RCPilot1604/Player-Piano/README.md

**Work in progress**
Detailed writeup here: https://urbanmakerkraft.com/2024/08/10/player-piano-project-v1/
