RCPilot1604/Player-Piano/Player Piano/src/Schematic.docx

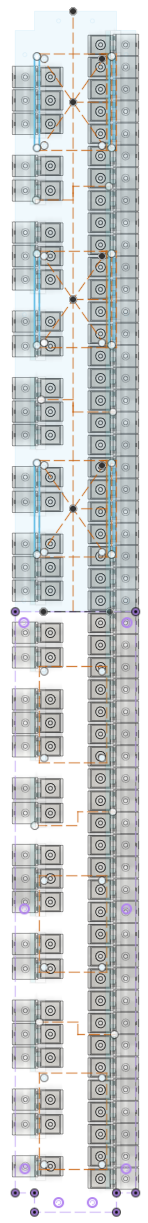
[picture p1: figure]
