RCPilot1604/Player-Piano/CAD/Player Piano Mechanism v41.step

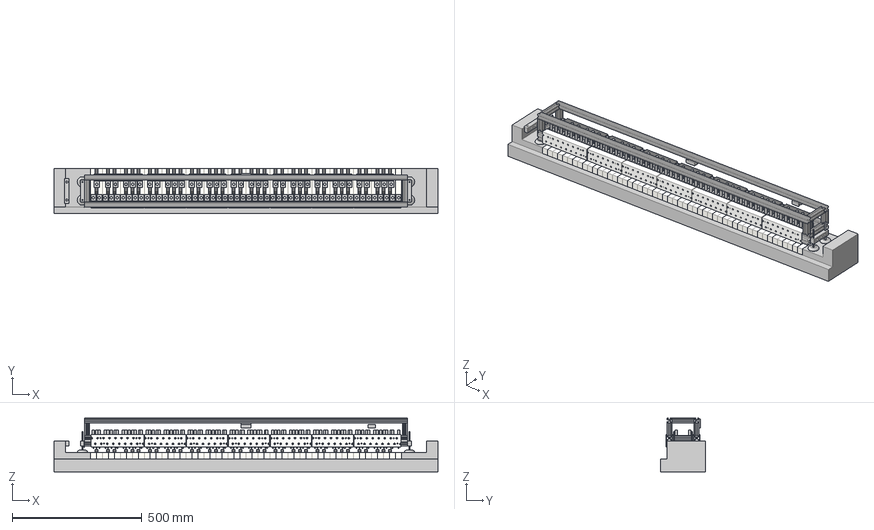
[picture p2: CAD file, 2025-01-10]
CAD/Player Piano Mechanism v41.step
1480.0 x 175.0 x 207.8 mm
Left Depth Rail
Positioning_Pole
Right Depth Rail
Legs
Front Left Pillar
2040 Profile
Back Left Pillar
Front Right Pillar
Back Right Pillar
Top Left Depth Rail
Top Right Depth Rail
Top Front Length Rail
Top Back Length Rail
2040 Profile(Mirror)
White
Black
Coil x 88
Frame_1 x 88
Plunger x 88
New White Solenoid Mount
New Black Solenoid Mount
PCB
