RCPilot1604/Player-Piano/(list of files, cad)

Other CAD files:
CAD/Player Piano Mechanism.f3z
