RCPilot1604/Player-Piano/EAGLE/Board.brd

## EAGLE design EAGLE/Board.brd (2024-07-26)

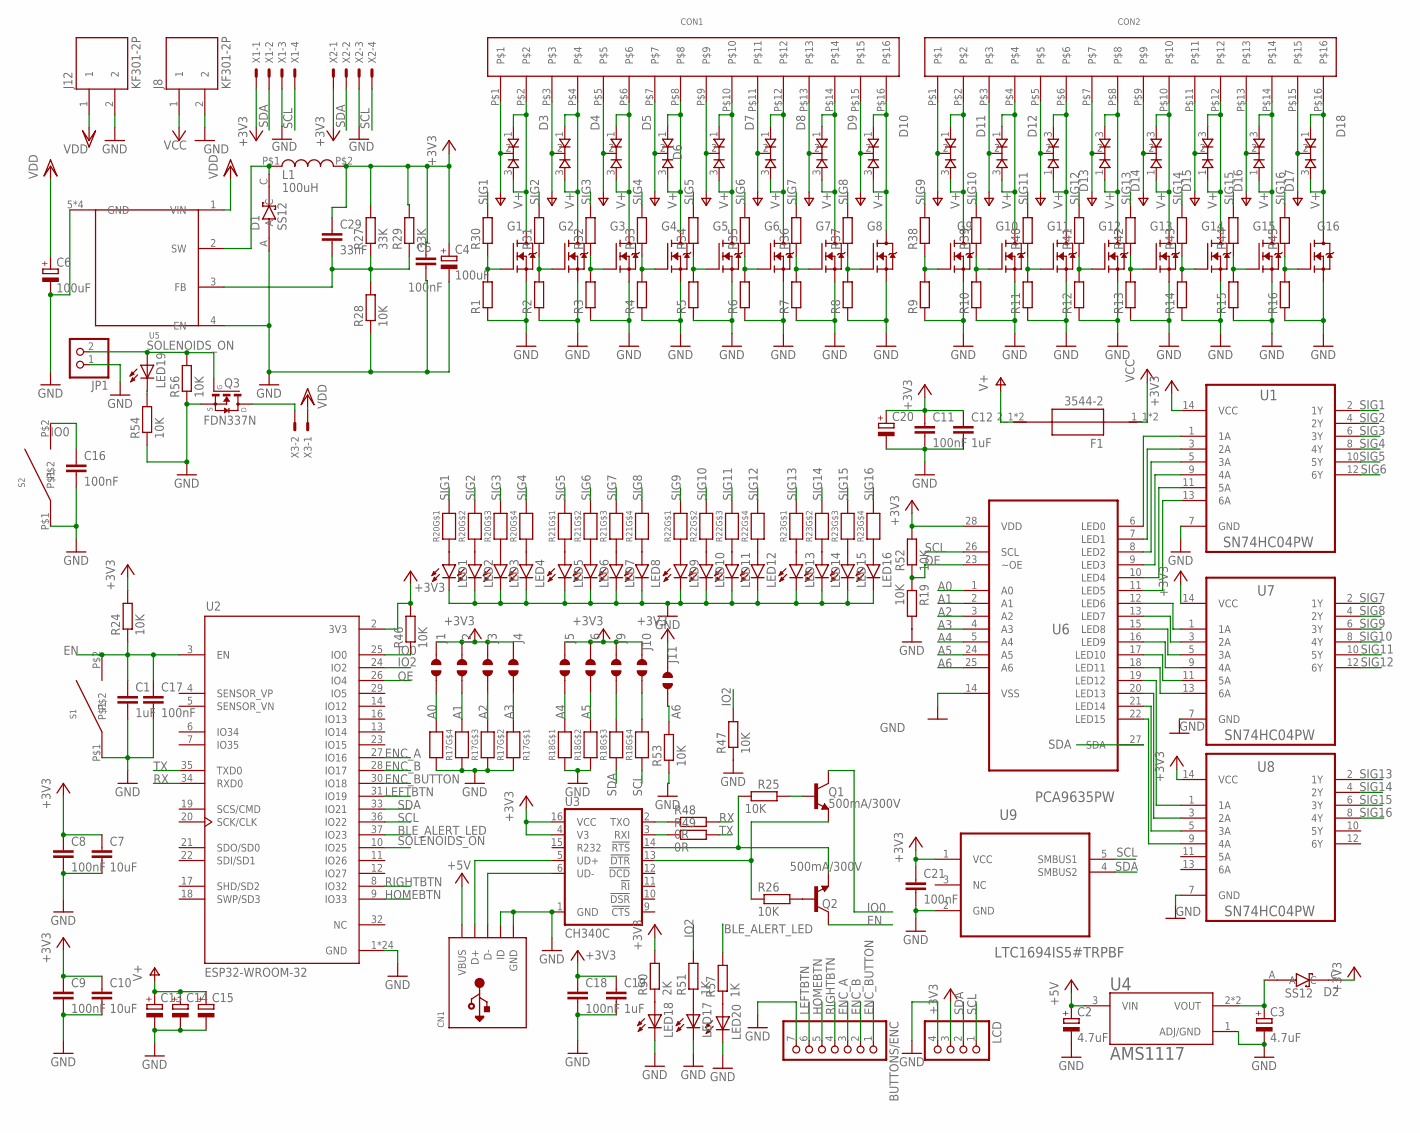
[picture p3: schematic Board.sch]

Parts:
BUTTONS/ENC: PINHD-1X7; 1X07
C1, C12, C19: 1uF; C0603
C2, C3: 4.7uF; C/6032-28R
C4, C6: 100uF; C/6032-28R
C5, C8, C9, C11, C16, C17, C18, C21: 100nF; C0603
C7, C10: 10uF; C0603
C13, C14, C15: CPOL-EUE5-10.5; E5-10,5
C20: CPOL-EUB; PANASONIC_B
C29: 33nF; C0603
CN1: USBMINIB; USB-MINIB
CON1, CON2: 2.54-16P
D1, D2: SS12; DIOM4427X270N
D3, D4, D5, D6, D7, D8, D9, D10, D11, D12, D13, D14, D15, D16, D17, D18: BYQ28E; TO220V
F1: 3544-2; FUSE_3544-2
G1, G2, G3, G4, G5, G6, G7, G8, G9, G10, G11, G12, G13, G14, G15, G16: IRL540N; TO220V
J1, J2, J3, J4, J5, J6, J9, J10, J11: JUMPER_SOLDER_1X2
J8, J12: KF301-2P
JP1: PINHD-1X2; 1X02
L1: 100uH; CD43
LCD: PINHD-1X4; 1X04
LED1, LED2, LED3, LED4, LED5, LED6, LED7, LED8, LED9, LED10, LED11, LED12, LED13, LED14, LED15, LED16: LEDSMT1206; 1206
LED17, LED18, LED19, LED20: LED-0603; LED-603
Q1, Q2: 500mA/300V; SOT23-3
Q3: FDN337N; SSOT-3
R1, R2, R3, R4, R5, R6, R7, R8, R9, R10, R11, R12, R13, R14, R15, R16, R30, R31, R32, R33, R34, R35, R36, R37, R38, R39, R40, R41, R42, R43, R44, R45: R-EU_R0603; R0603
R17, R18, R20, R21, R22, R23: MICROBUILDER_RESISTOR_4PACK; MICROBUILDER_RESPACK_4X0603
R19: 10K; R1206
R24, R25, R26, R28, R46, R47, R52, R53, R54, R56: 10K; R0603
R27, R29: 33K; R0603
R48, R49: 0R; R0603
R50: 2K; R0603
R51, R57: 1K; R0603
S1, S2: 3X6X2.5
U1, U7, U8: SN74HC04PW; SOP65P640X120-14N
U2: ESP32-WROOM-32; MODULE_ESP32-WROOM-32
U3: CH340C; SO016
U4: AMS1117; SOT229P700X180-4N
U5: XL7005A; SO8
U6: PCA9635PW; SOP65P640X110-28N
U9: LTC1694IS5#TRPBF; SOT95P280X100-5N
X1, X2: JST-XH-04-PIN-LONG-PAD; JST-XH-04-PACKAGE-LONG-PAD
X3: JST-XH-02-PIN-LONG-PAD; JST-XH-02-PACKAGE-LONG-PAD

Connections:
+3V3: C4.+, C5.1, C7.1, C8.1, C9.1, C10.1, C11.1, C12.1, C18.1, C19.1, C20.+, C21.1, C29.1, D2.C, J1.1, J2.1, J3.1, J4.1, J5.1, J6.1, J9.1, J10.1, J11.1, L1.P$2, LCD.3, R24.2, R27.2, R29.2, R46.2, R50.2, R52.2, U1.14 (VCC), U2.2 (3V3), U3.4 (V3), U3.16 (VCC), U6.28 (VDD), U7.14 (VCC), U8.14 (VCC), U9.1 (VCC), X1.1, X2.1
+5V: C2.+, CN1.VBUS, U4.3 (VIN)
A0: J1.2, R17.4 (1), U6.1 (A0)
A1: J2.2, R17.3 (1), U6.2 (A1)
A2: J3.2, R17.2 (1), U6.3 (A2)
A3: J4.2, R17.1, U6.4 (A3)
A4: J5.2, R18.8 (2), U6.5 (A4)
A5: J6.2, R18.7 (2), U6.24 (A5)
A6: J11.2, R53.2, U6.25 (A6)
BLE_ALERT_LED: R57.2, U2.37 (IO23)
EN: C1.1, C17.1, Q2.3 (C), R24.1, S1.P$2, U2.3 (EN)
ENC_A: BUTTONS/ENC.3, U2.27 (IO16)
ENC_B: BUTTONS/ENC.2, U2.28 (IO17)
ENC_BUTTON: BUTTONS/ENC.1, U2.30 (IO18)
GND: BUTTONS/ENC.7, C1.2, C2.-, C3.-, C4.-, C5.2, C6.-, C7.2, C8.2, C9.2, C10.2, C11.2, C12.2, C13.-, C14.-, C15.-, C16.2, C17.2, C18.2, C19.2, C20.-, C21.2, CN1.GND, CN1.ID, D1.A, G1.3 (S), G2.3 (S), G3.3 (S), G4.3 (S), G5.3 (S), G6.3 (S), G7.3 (S), G8.3 (S), G9.3 (S), G10.3 (S), G11.3 (S), G12.3 (S), G13.3 (S), G14.3 (S), G15.3 (S), G16.3 (S), J8.2, J12.2, JP1.1, LCD.4, LED1.C, LED2.C, LED3.C, LED4.C, LED5.C, LED6.C, LED7.C, LED8.C, LED9.C, LED10.C, LED11.C, LED12.C, LED13.C, LED14.C, LED15.C, LED16.C, LED17.C, LED18.C, LED20.C, Q3.2 (S), R1.1, R2.1, R3.1, R4.1, R5.1, R6.1, R7.1, R8.1, R9.1, R10.1, R11.1, R12.1, R13.1, R14.1, R15.1, R16.1, R17.5 (2), R17.6 (2), R17.7 (2), R17.8 (2), R18.1, R18.2 (1), R19.2, R28.1, R47.1, R53.1, R54.1, R56.1, S1.P$1, S2.P$1, U1.7 (GND), U2.1 (GND), U2.15 (GND), U2.38 (GND), U2.39_1 (GND), U2.39_2 (GND), U2.39_3 (GND), U2.39_4 (GND), U2.39_5 (GND), U2.39_6 (GND), U2.39_7 (GND), U2.39_8 (GND), U2.39_9 (GND), U2.39_10 (GND), U2.39_11 (GND), U2.39_12 (GND), U2.39_13 (GND), U2.39_14 (GND), U2.39_15 (GND), U2.39_16 (GND), U2.39_17 (GND), U2.39_18 (GND), U2.39_19 (GND), U2.39_20 (GND), U2.39_21 (GND), U3.1 (GND), U4.1 (ADJ/GND), U5.4 (EN), U5.5 (GND), U5.6 (GND), U5.7 (GND), U5.8 (GND), U6.14 (VSS), U7.7 (GND), U8.7 (GND), U9.2 (GND), X1.3, X2.3
HOMEBTN: BUTTONS/ENC.5, U2.9 (IO33)
IO0: C16.1, Q1.3 (C), R46.1, S2.P$2, U2.25 (IO0)
IO2: R47.2, R51.2, U2.24 (IO2)
LEFTBTN: BUTTONS/ENC.6, U2.31 (IO19)
unnamed: CON1.P$2, D3.1, D3.3, G1.2 (D)
unnamed: CON1.P$4, D4.1, D4.3, G2.2 (D)
unnamed: CON1.P$6, D5.1, D5.3, G3.2 (D)
unnamed: CON1.P$8, D6.1, D6.3, G4.2 (D)
unnamed: CON1.P$10, D7.1, D7.3, G5.2 (D)
unnamed: CON1.P$12, D8.1, D8.3, G6.2 (D)
unnamed: CON1.P$14, D9.1, D9.3, G7.2 (D)
unnamed: CON1.P$16, D10.1, D10.3, G8.2 (D)
unnamed: CON2.P$2, D11.1, D11.3, G9.2 (D)
unnamed: CON2.P$4, D12.1, D12.3, G10.2 (D)
unnamed: CON2.P$6, D13.1, D13.3, G11.2 (D)
unnamed: CON2.P$8, D14.1, D14.3, G12.2 (D)
unnamed: CON2.P$10, D15.1, D15.3, G13.2 (D)
unnamed: CON2.P$12, D16.1, D16.3, G14.2 (D)
unnamed: CON2.P$14, D17.1, D17.3, G15.2 (D)
unnamed: CON2.P$16, D18.1, D18.3, G16.2 (D)
unnamed: Q1.1 (B), R25.2
unnamed: Q2.1 (B), R26.2
unnamed: LED1.A, R20.1
unnamed: LED2.A, R20.2 (1)
unnamed: LED3.A, R20.3 (1)
unnamed: LED4.A, R20.4 (1)
unnamed: LED5.A, R21.1
unnamed: LED6.A, R21.2 (1)
unnamed: LED7.A, R21.3 (1)
unnamed: G1.1 (G), R1.2, R30.1
unnamed: LED8.A, R21.4 (1)
unnamed: LED9.A, R22.1
unnamed: LED10.A, R22.2 (1)
unnamed: LED11.A, R22.3 (1)
unnamed: LED12.A, R22.4 (1)
unnamed: LED13.A, R23.1
unnamed: LED14.A, R23.2 (1)
unnamed: LED15.A, R23.3 (1)
unnamed: Q2.2 (E), R25.1, U3.14 (!RTS)
unnamed: Q1.2 (E), R26.1, U3.13 (!DTR)
unnamed: Q3.3 (D), X3.2
unnamed: J9.2, R18.6 (2)
unnamed: CN1.D-, U3.6 (UD-)
unnamed: CN1.D+, U3.5 (UD+)
unnamed: J10.2, R18.5 (2)
unnamed: C3.+, D2.A, U4.2 (VOUT), U4.4 (VOUT)
unnamed: LED16.A, R23.4 (1)
unnamed: C29.2, R27.1, R28.2, R29.1, U5.3 (FB)
unnamed: G2.1 (G), R2.2, R31.1
unnamed: R48.1, U3.2 (TXO)
unnamed: G3.1 (G), R3.2, R32.1
unnamed: R49.1, U3.3 (RXI)
unnamed: G4.1 (G), R4.2, R33.1
unnamed: LED20.A, R57.1
unnamed: G5.1 (G), R5.2, R34.1
unnamed: G6.1 (G), R6.2, R35.1
unnamed: G7.1 (G), R7.2, R36.1
unnamed: LED18.A, R50.1
unnamed: G8.1 (G), R8.2, R37.1
unnamed: G9.1 (G), R9.2, R38.1
unnamed: G10.1 (G), R10.2, R39.1
unnamed: G11.1 (G), R11.2, R40.1
unnamed: G12.1 (G), R12.2, R41.1
unnamed: G13.1 (G), R13.2, R42.1
unnamed: G14.1 (G), R14.2, R43.1
unnamed: G15.1 (G), R15.2, R44.1
unnamed: G16.1 (G), R16.2, R45.1
unnamed: LED17.A, R51.1
unnamed: D1.C, L1.P$1, U5.2 (SW)
unnamed: U1.1 (1A), U6.6 (LED0)
unnamed: U1.3 (2A), U6.7 (LED1)
unnamed: U1.5 (3A), U6.8 (LED2)
unnamed: U1.9 (4A), U6.9 (LED3)
unnamed: U1.11 (5A), U6.10 (LED4)
unnamed: U1.13 (6A), U6.11 (LED5)
unnamed: U6.12 (LED6), U7.1 (1A)
unnamed: U6.13 (LED7), U7.3 (2A)
unnamed: U6.15 (LED8), U7.5 (3A)
unnamed: U6.16 (LED9), U7.9 (4A)
unnamed: U6.17 (LED10), U7.11 (5A)
unnamed: U6.18 (LED11), U7.13 (6A)
unnamed: U6.19 (LED12), U8.1 (1A)
unnamed: U6.20 (LED13), U8.3 (2A)
unnamed: U6.21 (LED14), U8.5 (3A)
unnamed: U6.22 (LED15), U8.9 (4A)
unnamed: LED19.C, R54.2
OE: R19.1, R52.1, U2.26 (IO4), U6.23 (~OE)
RIGHTBTN: BUTTONS/ENC.4, U2.8 (IO32)
RX: R48.2, U2.34 (RXD0)
SCL: LCD.1, R18.4 (1), U2.36 (IO22), U6.26 (SCL), U9.5 (SMBUS1), X1.4, X2.4
SDA: LCD.2, R18.3 (1), U2.33 (IO21), U6.27 (SDA), U9.4 (SMBUS2), X1.2, X2.2
SIG1: R20.8 (2), R30.2, U1.2 (1Y)
SIG2: R20.7 (2), R31.2, U1.4 (2Y)
SIG3: R20.6 (2), R32.2, U1.6 (3Y)
SIG4: R20.5 (2), R33.2, U1.8 (4Y)
SIG5: R21.8 (2), R34.2, U1.10 (5Y)
SIG6: R21.7 (2), R35.2, U1.12 (6Y)
SIG7: R21.6 (2), R36.2, U7.2 (1Y)
SIG8: R21.5 (2), R37.2, U7.4 (2Y)
SIG9: R22.8 (2), R38.2, U7.6 (3Y)
SIG10: R22.7 (2), R39.2, U7.8 (4Y)
SIG11: R22.6 (2), R40.2, U7.10 (5Y)
SIG12: R22.5 (2), R41.2, U7.12 (6Y)
SIG13: R23.8 (2), R42.2, U8.2 (1Y)
SIG14: R23.7 (2), R43.2, U8.4 (2Y)
SIG15: R23.6 (2), R44.2, U8.6 (3Y)
SIG16: R23.5 (2), R45.2, U8.8 (4Y)
SOLENOIDS_ON: JP1.2, LED19.A, Q3.1 (G), R56.2, U2.10 (IO25)
TX: R49.2, U2.35 (TXD0)
V+: C13.+, C14.+, C15.+, CON1.P$1, CON1.P$3, CON1.P$5, CON1.P$7, CON1.P$9, CON1.P$11, CON1.P$13, CON1.P$15, CON2.P$1, CON2.P$3, CON2.P$5, CON2.P$7, CON2.P$9, CON2.P$11, CON2.P$13, CON2.P$15, D3.2, D4.2, D5.2, D6.2, D7.2, D8.2, D9.2, D10.2, D11.2, D12.2, D13.2, D14.2, D15.2, D16.2, D17.2, D18.2, F1.2_1 (2), F1.2_2 (2)
VCC: F1.1_1 (1), F1.1_2 (1), J8.1
VDD: C6.+, J12.1, U5.1 (VIN), X3.1

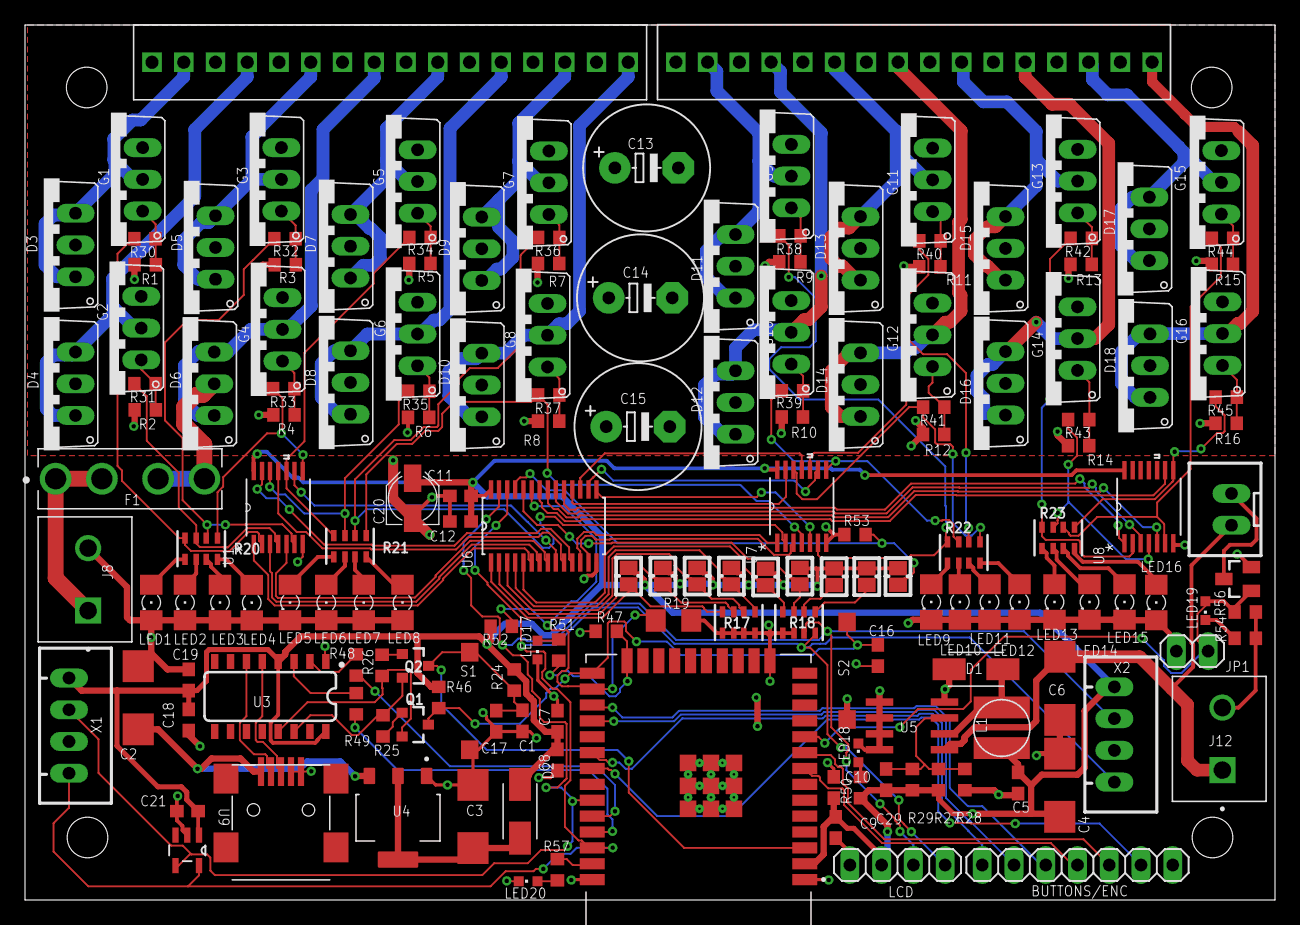
[picture p4: board Board.brd from above]

Board: 2 copper layers, 100.0 x 70.0 mm, 168 parts (0 on the bottom side), 127 nets.
