RCPilot1604/Player-Piano/(commit log)

2024-07-26 Added EAGLE Schematics and Board
    [Board Old.brd, Board Old.sch, Board.brd, Board.sch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]
2024-11-28 Move project to PlatformIO
    [pyvenv.cfg]
2024-11-28 Revert "Add OTA code"
    This reverts commit bd589469e9066f6d48da46c68686ae0b22e0317d.
    [Settings.h, main.cpp]
2024-11-28 Add bool to track if the previous note is a bounceback
    This is so we can check if the previous note will be able to finish
    since bounceback notes have a different duration as compared to
    normal notes.
2024-11-28 Modify main logic to consider case where prev note is BB
    We need to consider a different set of timing requirements
    since BB execution is of a different duration than standard.
    Therefore it could be possible to schedule in another BB if the
    previous note was a BB.
2024-11-28 Modify the current=OFF, previous=OFF condition
    If the current note is OFF and the previous is OFF, we should do
    nothing and just let the OFF carry on.
2024-11-28 Remove extra printouts
2024-11-28 Revert "Modify the current=OFF, previous=OFF condition"
    This reverts commit bfaedefec276a65907df6ce72c604d397b203f72.
    [main.cpp]
2024-11-29 Modify velocity phase voltage
2024-11-29 Remove print for scheduling bounceback
2024-12-27 Fix Display code to remove errors
    [Display.cpp, Display.h, main.cpp]
2025-01-10 Add CAD files
2026-05-29 Add git-filter-repo.txt to .gitignore
